sini6a/nrf24-remote-control/KiCad/nrf24le1-transmitter/Assets/2025-03-25_16-58_1.png

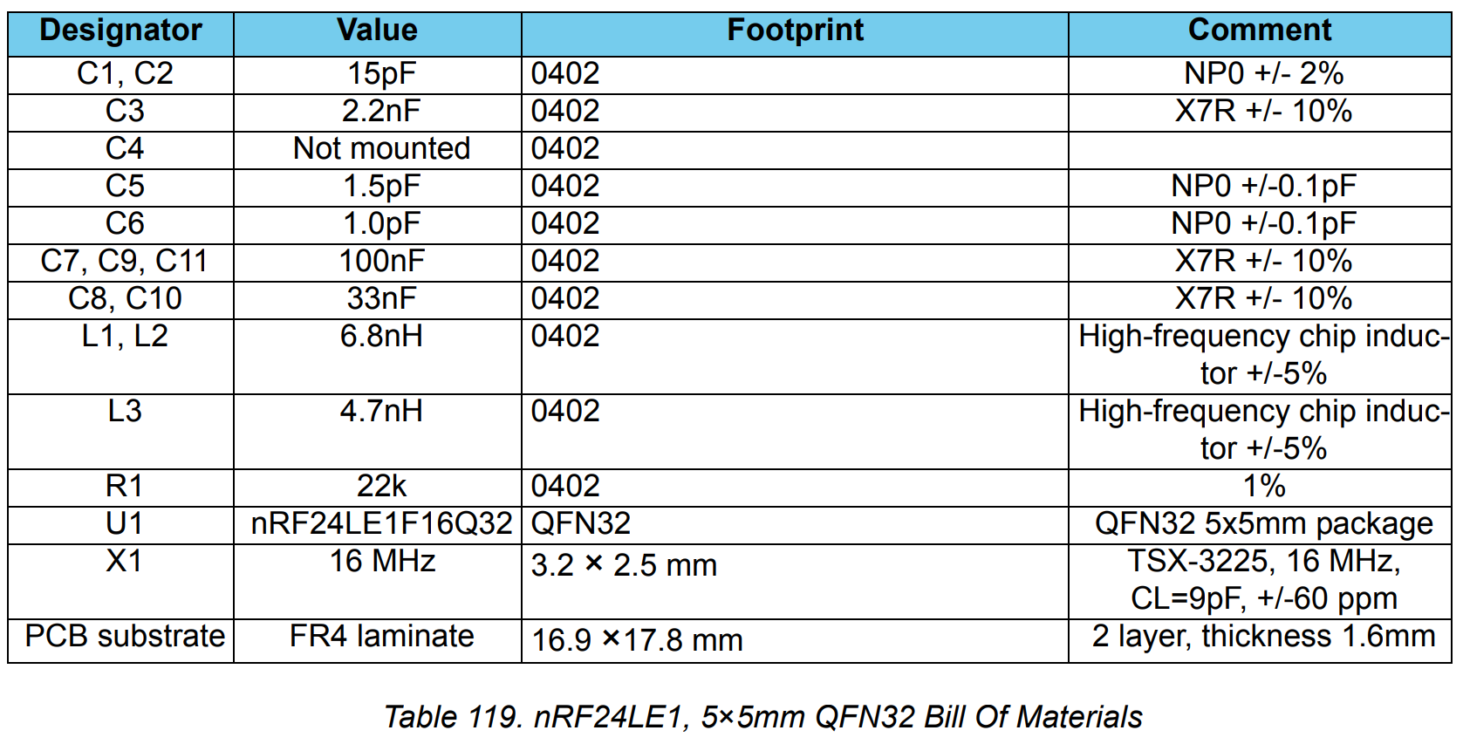
KiCad/nrf24le1-transmitter/Assets/2025-03-25_16-58_1.png
