sini6a/nrf24-remote-control/Firmware/nrf24le1-transmitter/FLASHING_GUIDE.md

# Transmitter Flashing Guide

## Prerequisite: SDCC compiler
This transmitter firmware is compiled with **SDCC** (Small Device C Compiler).

Download SDCC:
- Official site: https://sdcc.sourceforge.net/
- Downloads page: https://sourceforge.net/projects/sdcc/files/

## 1) Build transmitter firmware
From `Firmware/usb-remote-nrf24le1/`:

```bat
run.bat
```

Output file:
- `output.ihx`

## 2) Flash to nRF24LE1
Programmer tool location in this project:
- `nRF24LE1_Programmer/Desktop/Programmer.exe`

Example command:

```bat
.\nRF24LE1_Programmer\Desktop\Programmer.exe \\.\COM3 w .\output.ihx
```

Use your actual COM port.

## 3) Build and flash RX test firmware (optional)
For nRF24LE1-to-nRF24LE1 radio testing:

```bat
run_rx.bat
Programmer.exe \\.\COM3 w .\src\output_rx.ihx
```

## 4) Debug serial notes
- Default debug baud in this project is `19200`.
- Debug pin depends on package type (set in firmware logic).
- On 32-pin devices, UART TX is typically `P0.3`.
- Enable debug output by uncommenting `#define DEBUG` in `config.h`.
