sini6a/nrf24-remote-control/KiCad/nrf24le1-transmitter/usb-remote-nrf24le1.pdf

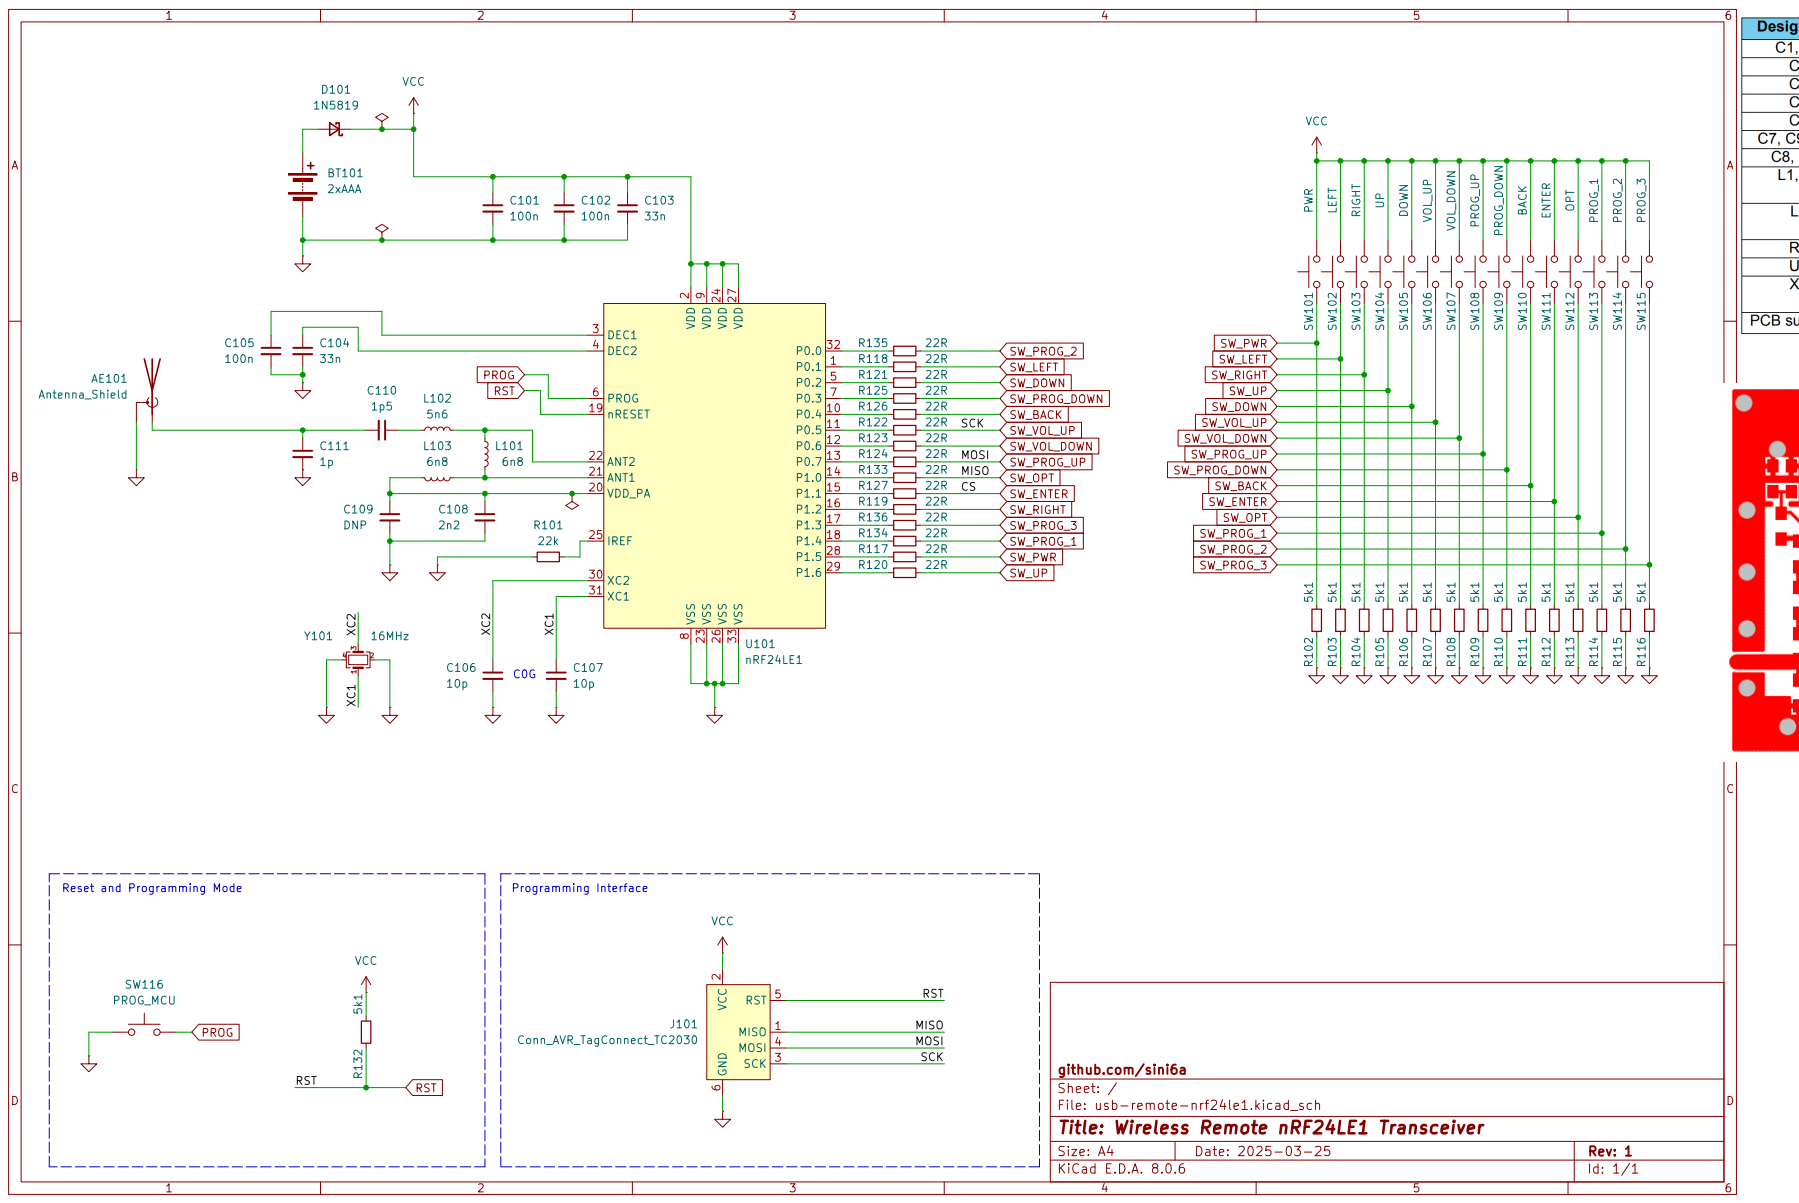
[picture p5: page 1]
