sini6a/nrf24-remote-control/KiCad/nrf52820-receiver/usb-remote-nrf52820-receiver.kicad_pcb

## KiCad design KiCad/nrf52820-receiver/usb-remote-nrf52820-receiver.kicad_pcb (2025-03-27)

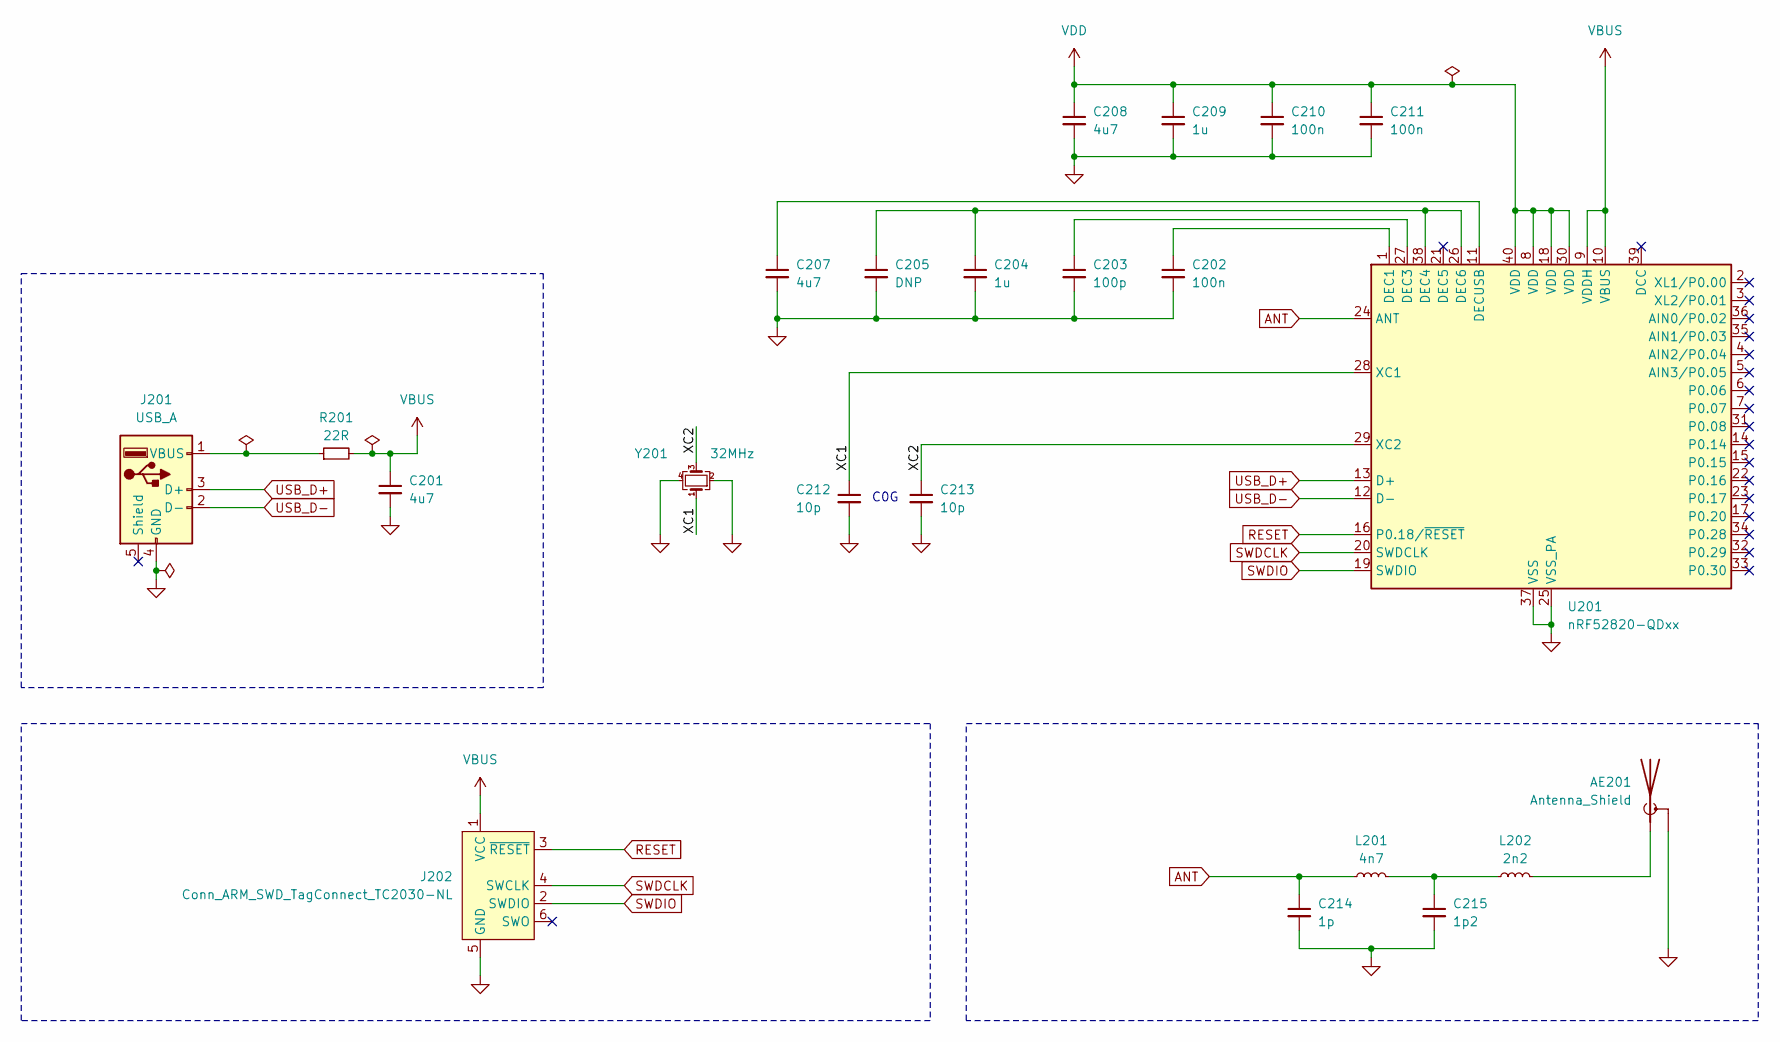
[picture p6: schematic usb-remote-nrf52820-receiver.kicad_sch]

Parts:
AE201: Antenna_Shield; Texas_SWRA117D_2.4GHz_Right
C201, C207, C208: 4u7; C_0603_1608Metric; MPN C19666
C202, C210, C211: 100n; C_0402_1005Metric; MPN C1525
C203: 100p; C_0402_1005Metric; MPN C1546
C204, C209: 1u; C_0402_1005Metric; MPN C52923
C205: DNP; C_0402_1005Metric
C212, C213: 10p; C_0402_1005Metric; MPN C32949
C214: 1p; C_0402_1005Metric; MPN C72134
C215: 1p2; C_0402_1005Metric; MPN C76899
J201: USB_A; PCB_USB_2.0
J202: Conn_ARM_SWD_TagConnect_TC2030-NL; Tag-Connect_TC2030-IDC-NL_2x03_P1.27mm_Vertical
L201: 4n7; L_0402_1005Metric; MPN C86065
L202: 2n2; L_0402_1005Metric; MPN C86061
R201: 22R; C_0402_1005Metric; MPN C25092
U201: nRF52820-QDxx; QFN-40-1EP_5x5mm_P0.4mm_EP3.6x3.6mm; MPN C3015612
Y201: 32MHz; Crystal_SMD_2016-4Pin_2.0x1.6mm; MPN C2901738

Connections:
/XC1: C212.1, U201.28 (XC1), Y201.1
/XC2: C213.1, U201.29 (XC2), Y201.3
ANT: C214.1, L201.1, U201.24 (ANT)
GND: AE201.2 (Shield), C201.2, C202.2, C203.2, C204.2, C205.2, C207.2, C208.2, C209.2, C210.2, C211.2, C212.2, C213.2, C214.2, C215.2, J201.4 (GND), J202.5 (GND), U201.25 (VSS_PA), U201.37 (VSS), U201.41 (VSS), Y201.2, Y201.4
unnamed: AE201.1 (A), L202.2
unnamed: C215.1, L201.2, L202.1
unnamed: J201.1 (VBUS), R201.1
unnamed: C202.1, U201.1 (DEC1)
unnamed: C203.1, U201.27 (DEC3)
unnamed: C204.1, C205.1, U201.26 (DEC6), U201.38 (DEC4)
unnamed: C207.1, U201.11 (DECUSB)
RESET: J202.3 (~RESET), U201.16 (P0.18/~RESET)
SWDCLK: J202.4 (SWCLK), U201.20 (SWDCLK)
SWDIO: J202.2 (SWDIO), U201.19 (SWDIO)
USB_D+: J201.3 (D+), U201.13 (D+)
USB_D-: J201.2 (D-), U201.12 (D-)
VBUS: C201.1, J202.1 (VCC), R201.2, U201.9 (VDDH), U201.10 (VBUS)
VDD: C208.1, C209.1, C210.1, C211.1, U201.8 (VDD), U201.18 (VDD), U201.30 (VDD), U201.40 (VDD)

Notes on the sheet:
C0G

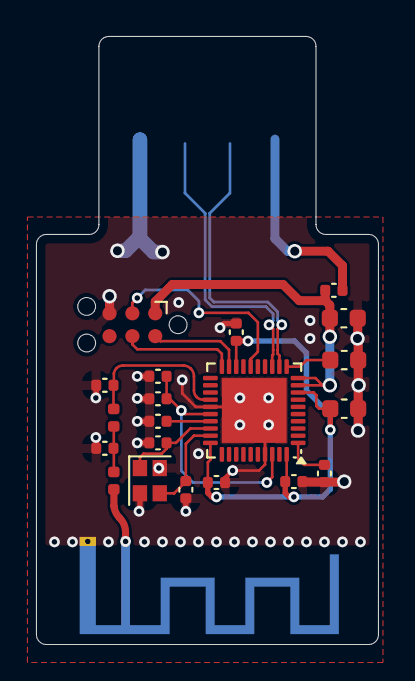
[picture p7: board usb-remote-nrf52820-receiver.kicad_pcb from above]

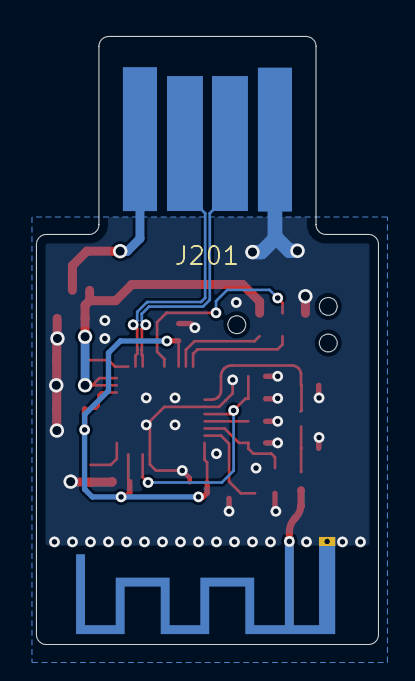
[picture p8: board usb-remote-nrf52820-receiver.kicad_pcb from below]

Board: 2 copper layers, 19.0 x 33.8 mm, 22 parts (2 on the bottom side), 18 nets.
