sini6a/nrf24-remote-control/KiCad/nrf24le1-transmitter/usb-remote-nrf24le1.kicad_pcb

## KiCad design KiCad/nrf24le1-transmitter/usb-remote-nrf24le1.kicad_pcb (2026-04-14)

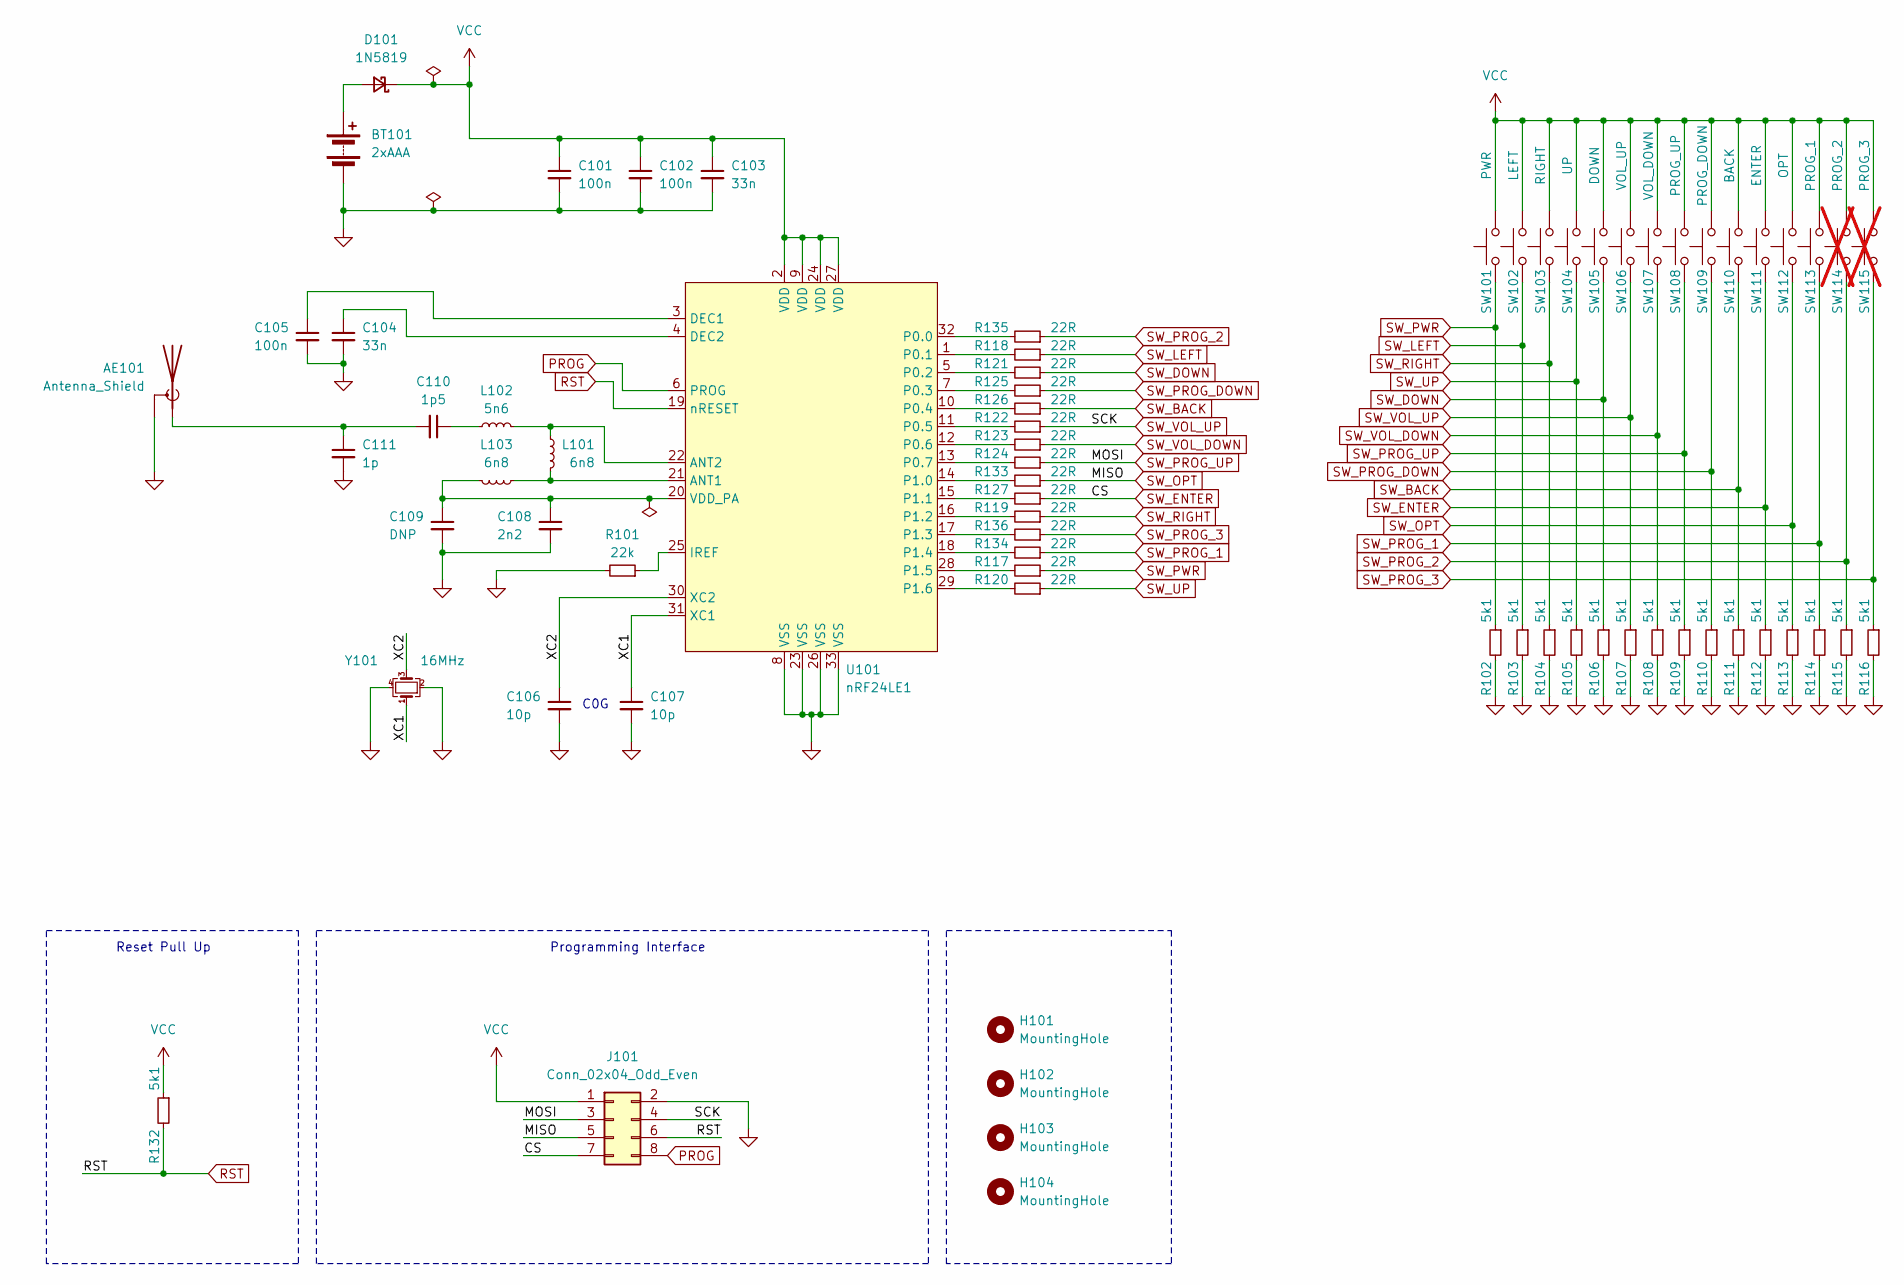
[picture p9: schematic usb-remote-nrf24le1.kicad_sch, Wireless Remote nRF24LE1 Transmitter]

Parts:
AE101: Antenna_Shield; Texas_SWRA117D_2.4GHz_Right
BT101: 2xAAA; BatteryHolder_Keystone_2468_2xAAA
C101, C102, C105: 100n; C_0402_1005Metric; MPN C1525
C103, C104: 33n; C_0603_1608Metric; MPN C21117
C106, C107: 10p; C_0402_1005Metric; MPN C32949
C108: 2n2; C_0402_1005Metric; MPN C84703
C109: DNP; C_0402_1005Metric
C110: 1p5; C_0402_1005Metric; MPN C76900
C111: 1p; C_0402_1005Metric; MPN C72134
D101: 1N5819; D_SMA; MPN C2480
H101, H102, H103, H104: MountingHole; MountingHole_2.2mm_M2_ISO7380
J101: Conn_02x04_Odd_Even; PinHeader_2x04_P2.54mm_Vertical
L101, L103: 6n8; L_0402_1005Metric; MPN C77110
L102: 5n6; L_0402_1005Metric; MPN C85670
R101: 22k; R_0402_1005Metric; MPN C25768
R102, R103, R104, R105, R106, R107, R108, R109, R110, R111, R112, R113, R114, R115, R116, R132: 5k1; R_0402_1005Metric; MPN C25905
R117, R118, R119, R120, R121, R122, R123, R124, R125, R126, R127, R133, R134, R135, R136: 22R; R_0402_1005Metric; MPN C25092
SW101: PWR; SW_PUSH_6mm_H4.3mm
SW102: LEFT; SW_PUSH_6mm_H4.3mm
SW103: RIGHT; SW_PUSH_6mm_H4.3mm
SW104: UP; SW_PUSH_6mm_H4.3mm
SW105: DOWN; SW_PUSH_6mm_H4.3mm
SW106: VOL_UP; SW_PUSH_6mm_H4.3mm
SW107: VOL_DOWN; SW_PUSH_6mm_H4.3mm
SW108: PROG_UP; SW_PUSH_6mm_H4.3mm
SW109: PROG_DOWN; SW_PUSH_6mm_H4.3mm
SW110: BACK; SW_PUSH_6mm_H4.3mm
SW111: ENTER; SW_PUSH_6mm_H4.3mm
SW112: OPT; SW_PUSH_6mm_H4.3mm
SW113: PROG_1; SW_PUSH_6mm_H4.3mm
SW114: PROG_2; SW_Tactile_SPST_Angled_PTS645Vx31-2LFS; not fitted
SW115: PROG_3; SW_Tactile_SPST_Angled_PTS645Vx31-2LFS; not fitted
U101: nRF24LE1; QFN-32-1EP_5x5mm_P0.5mm_EP3.6x3.6mm_ThermalVias; MPN C18315
Y101: 16MHz; Crystal_SMD_3225-4Pin_3.2x2.5mm; MPN C13738

Connections:
/XC1: C107.1, U101.31 (XC1), Y101.1
/XC2: C106.1, U101.30 (XC2), Y101.3
GND: AE101.2 (Shield), BT101.2 (-), C101.2, C102.2, C103.2, C104.2, C105.2, C106.2, C107.2, C108.2, C109.2, C111.2, J101.2, R101.2, R102.2, R103.2, R104.2, R105.2, R106.2, R107.2, R108.2, R109.2, R110.2, R111.2, R112.2, R113.2, R114.2, R115.2, R116.2, U101.8 (VSS), U101.23 (VSS), U101.26 (VSS), U101.33 (VSS), Y101.2, Y101.4
unnamed: AE101.1 (A), C110.2, C111.1
unnamed: BT101.1 (+), D101.2 (A)
unnamed: C110.1, L102.2
unnamed: L101.1, L103.2, U101.21 (ANT1)
unnamed: L101.2, L102.1, U101.22 (ANT2)
unnamed: C105.1, U101.3 (DEC1)
unnamed: C104.1, U101.4 (DEC2)
unnamed: R101.1, U101.25 (IREF)
unnamed: R135.2, U101.32 (P0.0)
unnamed: R118.2, U101.1 (P0.1)
unnamed: R121.2, U101.5 (P0.2)
unnamed: R125.2, U101.7 (P0.3)
unnamed: R126.2, U101.10 (P0.4)
unnamed: R122.2, U101.11 (P0.5)
unnamed: R123.2, U101.12 (P0.6)
unnamed: R124.2, U101.13 (P0.7)
unnamed: R133.2, U101.14 (P1.0)
unnamed: R127.2, U101.15 (P1.1)
unnamed: R119.2, U101.16 (P1.2)
unnamed: R136.2, U101.17 (P1.3)
unnamed: R134.2, U101.18 (P1.4)
unnamed: R117.2, U101.28 (P1.5)
unnamed: R120.2, U101.29 (P1.6)
unnamed: C108.1, C109.1, L103.1, U101.20 (VDD_PA)
PROG: J101.8, U101.6 (PROG)
RST: J101.6, R132.2, U101.19 (nRESET)
SW_BACK: R111.1, R126.1, SW110.1
SW_DOWN: R106.1, R121.1, SW105.1
SW_ENTER: J101.7, R112.1, R127.1, SW111.1
SW_LEFT: R103.1, R118.1, SW102.1
SW_OPT: J101.5, R113.1, R133.1, SW112.1
SW_PROG_1: R114.1, R134.1, SW113.1
SW_PROG_2: R115.1, R135.1, SW114.1
SW_PROG_3: R116.1, R136.1, SW115.1
SW_PROG_DOWN: R110.1, R125.1, SW109.1
SW_PROG_UP: J101.3, R109.1, R124.1, SW108.1
SW_PWR: R102.1, R117.1, SW101.1
SW_RIGHT: R104.1, R119.1, SW103.1
SW_UP: R105.1, R120.1, SW104.1
SW_VOL_DOWN: R108.1, R123.1, SW107.1
SW_VOL_UP: J101.4, R107.1, R122.1, SW106.1
VCC: C101.1, C102.1, C103.1, D101.1 (K), J101.1, R132.1, SW101.2, SW102.2, SW103.2, SW104.2, SW105.2, SW106.2, SW107.2, SW108.2, SW109.2, SW110.2, SW111.2, SW112.2, SW113.2, SW114.2, SW115.2, U101.2 (VDD), U101.9 (VDD), U101.24 (VDD), U101.27 (VDD)

Notes on the sheet:
C0G
Programming Interface
Reset Pull Up

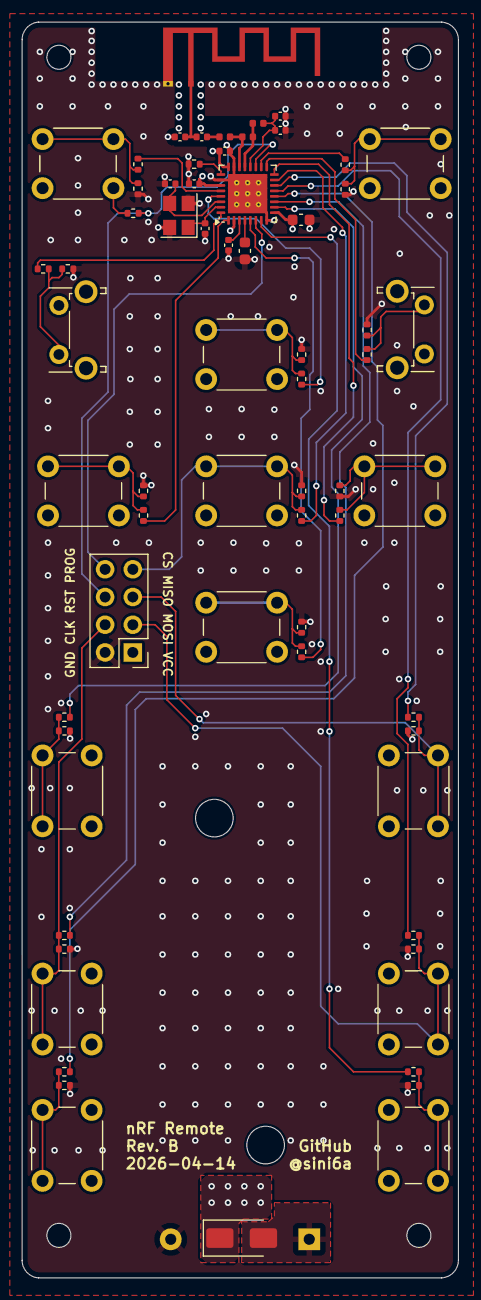
[picture p10: board usb-remote-nrf24le1.kicad_pcb from above]

Board: 4 copper layers, 40.0 x 115.1 mm, 71 parts (1 on the bottom side), 45 nets.
