sini6a/nrf24-remote-control/(commit log)

2026-04-14 redesigned programming header and routing cleanup
    [usb-remote-nrf24le1.kicad_pcb, usb-remote-nrf24le1.kicad_sch]
2026-04-18 added dependencies and cleanup
    [usb-remote-nrf24le1.kicad_pcb, usb-remote-nrf24le1.kicad_sch, usb-remote-nrf52820-receiver.kicad_pcb, usb-remote-nrf52820-receiver.kicad_sch]
